FraEgg/commodore-c128dcr-1571-switchless-floppydrive-8x-multi-floppy-speeder/atmega328p/README.md

## ATMega 328P

The Atmel ATMega 328P microcontroller monitors the data bus, controls the ROM banks, and manages the switching of operating modes. The firmware can be programmed using an Arduino board or an AV programmer. I use the XGecu T48 Universal Programmer with an .mpj project file. When programming with the XGecu and the .mpj file, make sure not to program the EEPROM as this can cause an error. This can be disabled in the XGecu menu.
