FraEgg/commodore-c128dcr-1571-switchless-floppydrive-8x-multi-floppy-speeder/images/README.md

# Switchless 8x Multi-Floppy Speeder with 32 KB RAM Expansion for the Commodore C128 DCR and Internal 1571 Floppy Drive (DolphinDOS 3 Compatible)

## Photogallery



### C128D CR 8x Switchless Multi-Speeder and 32KB RAM Expansion PCB (U101)

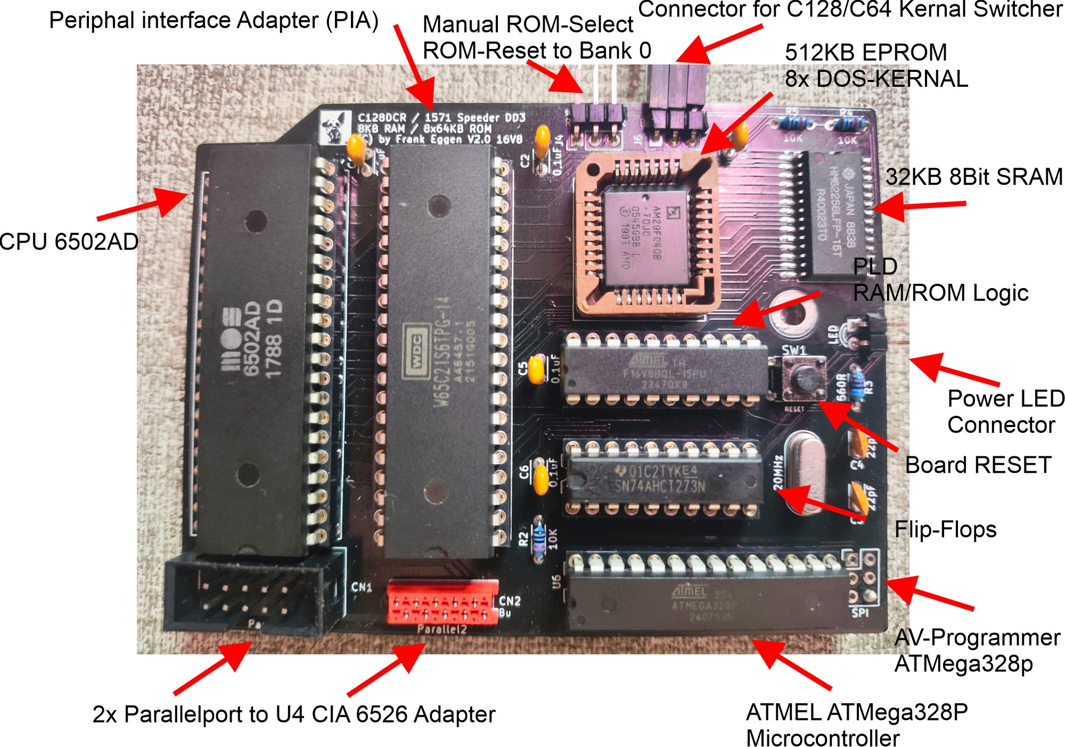
[picture p12: images/V2.0a_Galery2a.jpg]


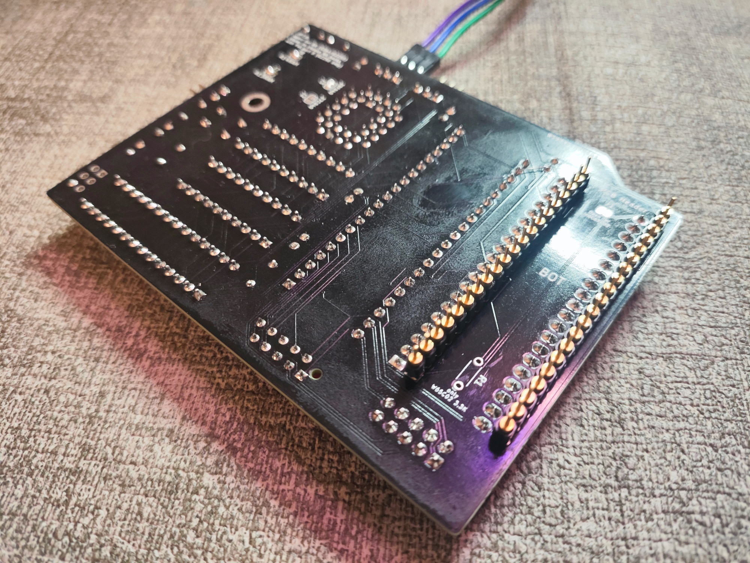
[picture p13: images/V2.0a_Galery3.jpg]


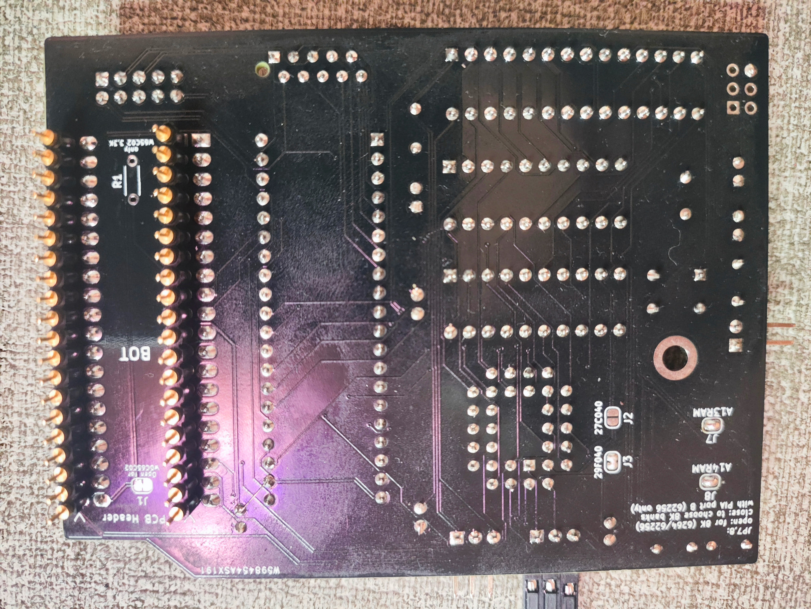
[picture p14: images/V2.0a_Galery4.jpg]


### C128D CR Mainboard Overview



### C128D CR C128/C64 Kernal Switcher (U32)

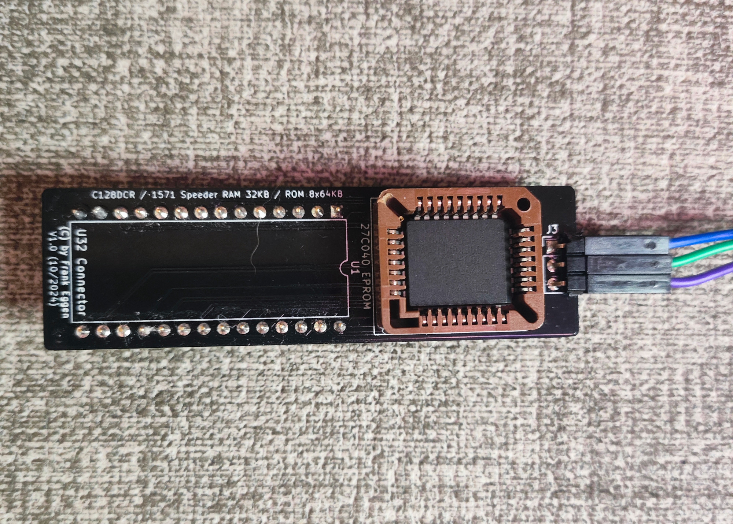
[picture p15: images/V2.0a_Galery5.jpg]


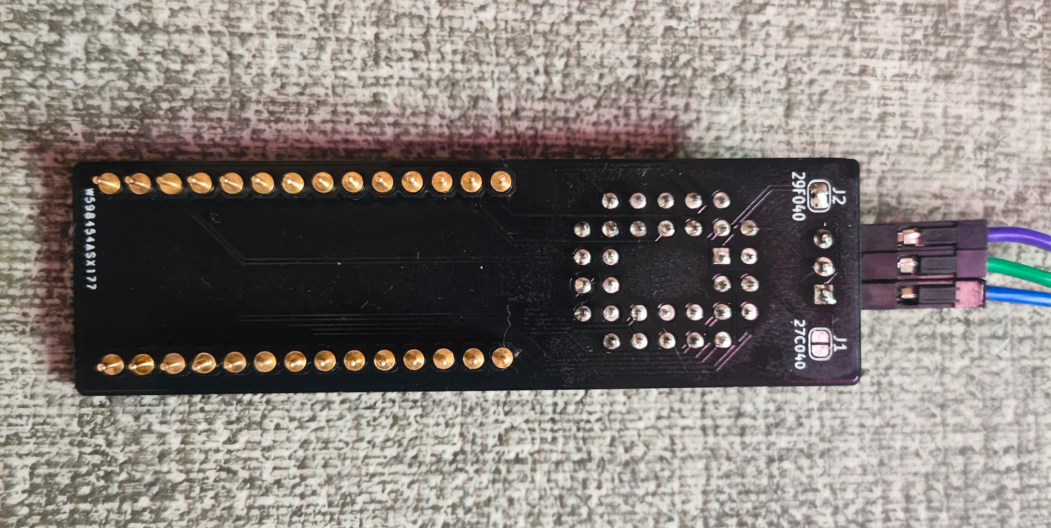
[picture p16: images/V2.0a_Galery6.jpg]


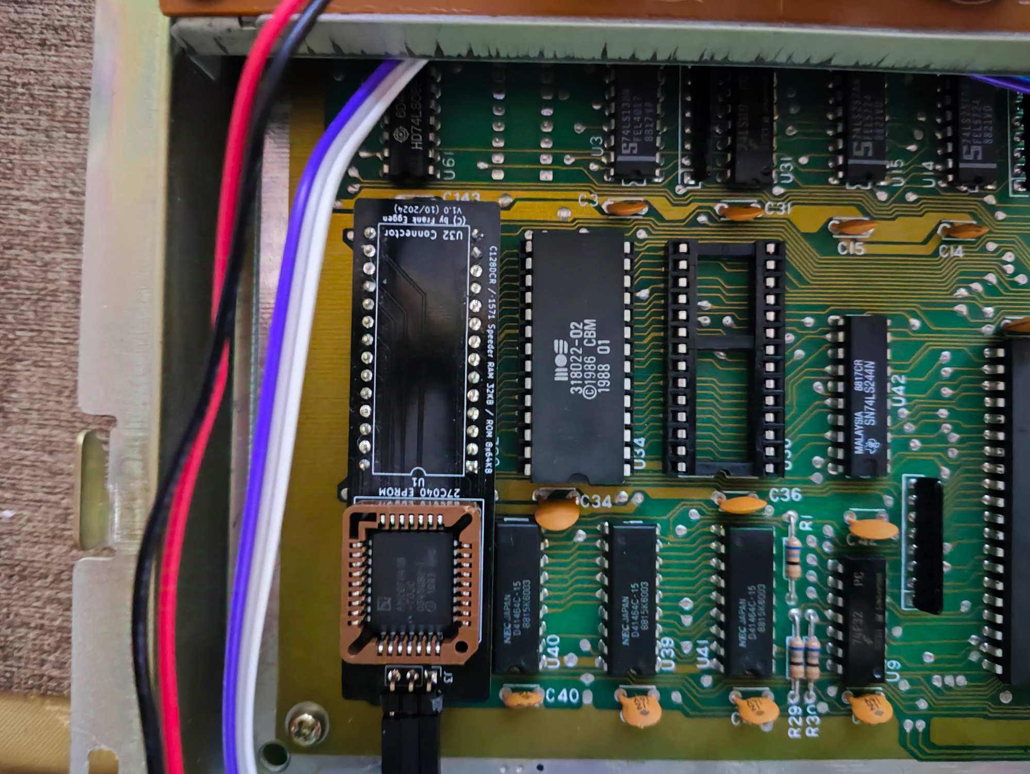
[picture p17: images/V2.0a_Galery11.jpg]


### C128D CR Parallelport-Adapter (U4)

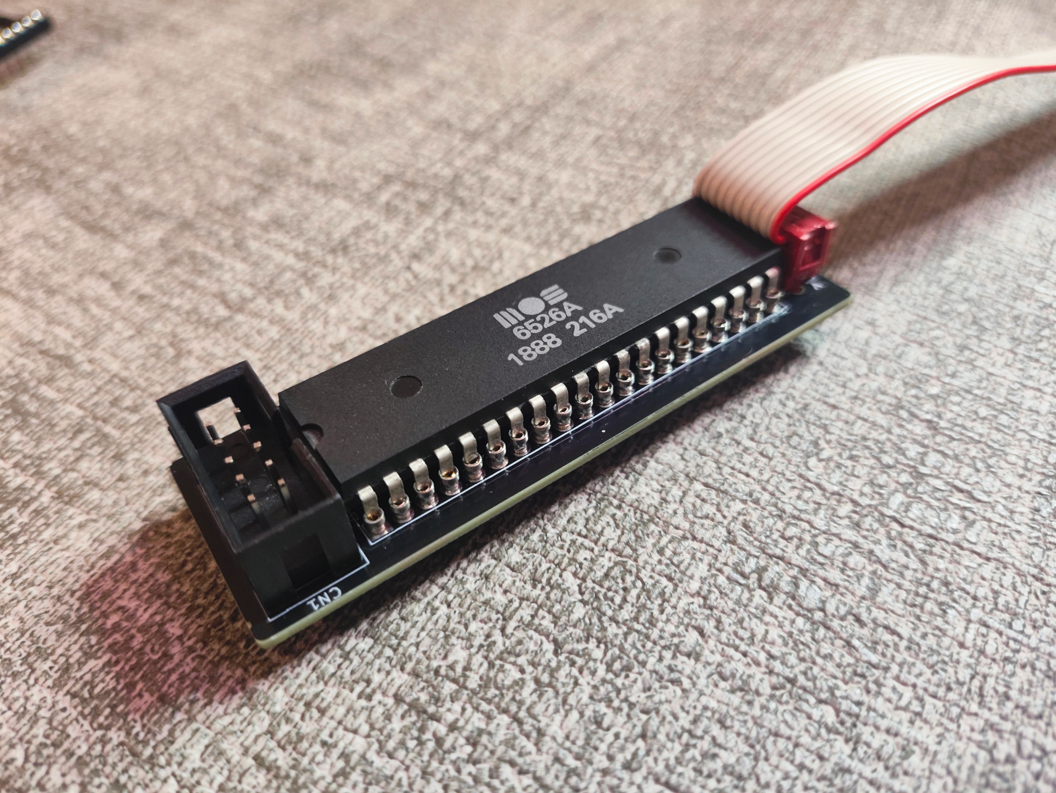
[picture p18: images/V2.0a_Galery7.jpg]


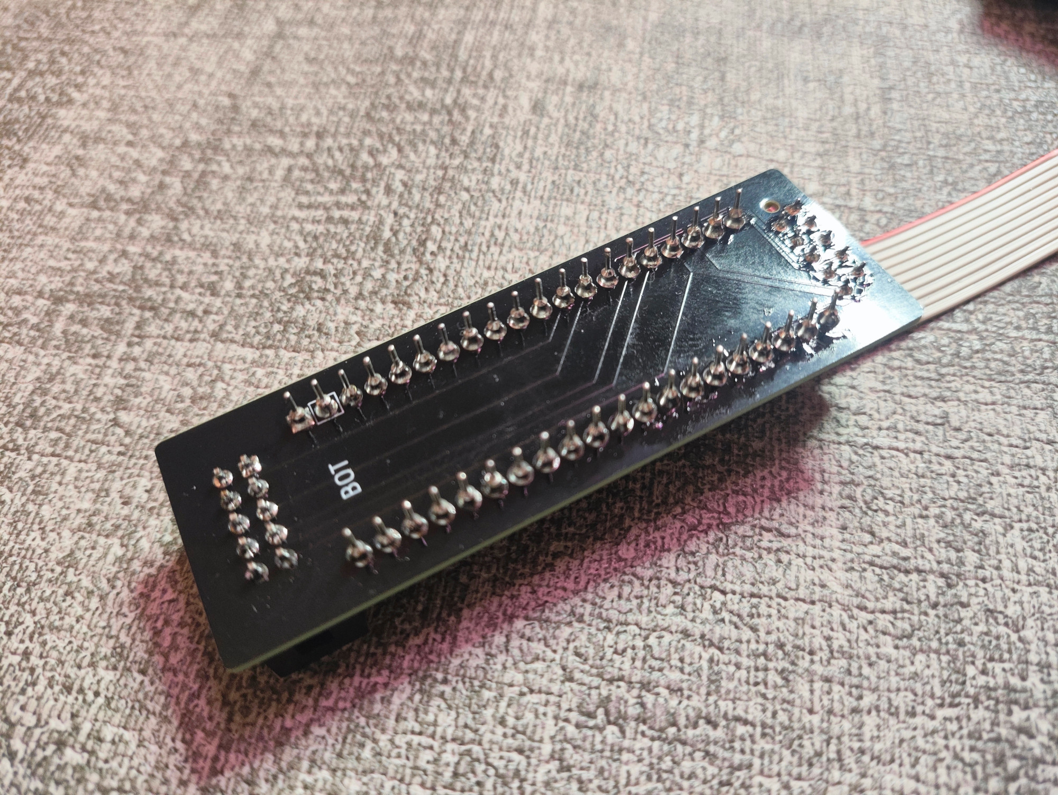
[picture p19: images/V2.0a_Galery8.jpg]


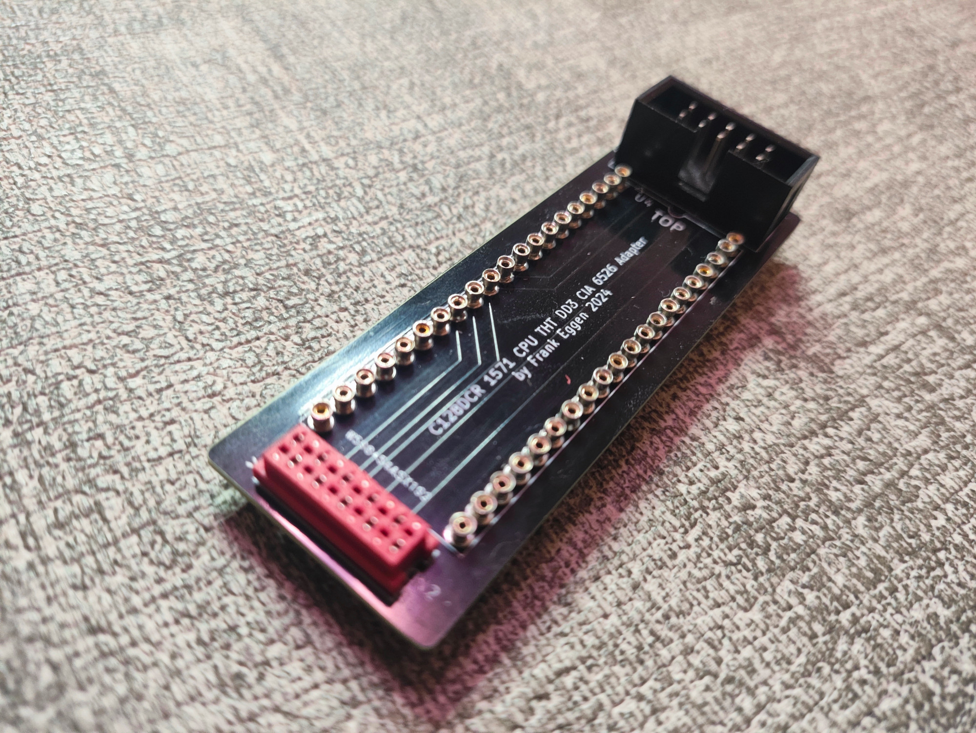
[picture p20: images/V2.0a_Galery9.jpg]


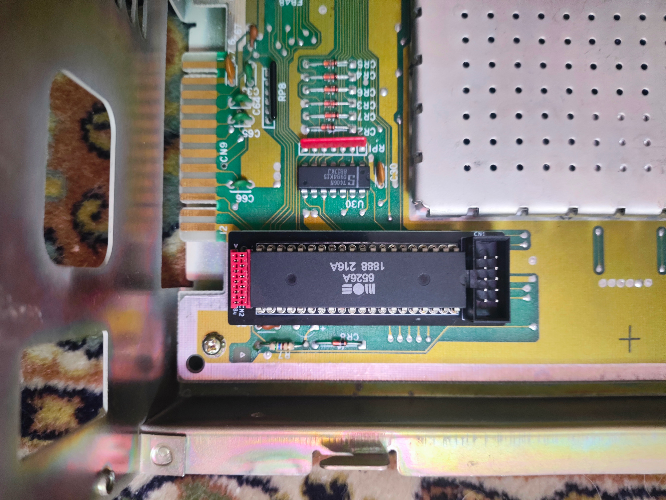
[picture p21: images/V2.0a_Galery10.jpg]


### C128D CR 8x Switchless Multi-Speeder and 32KB RAM Expansion Render PCB

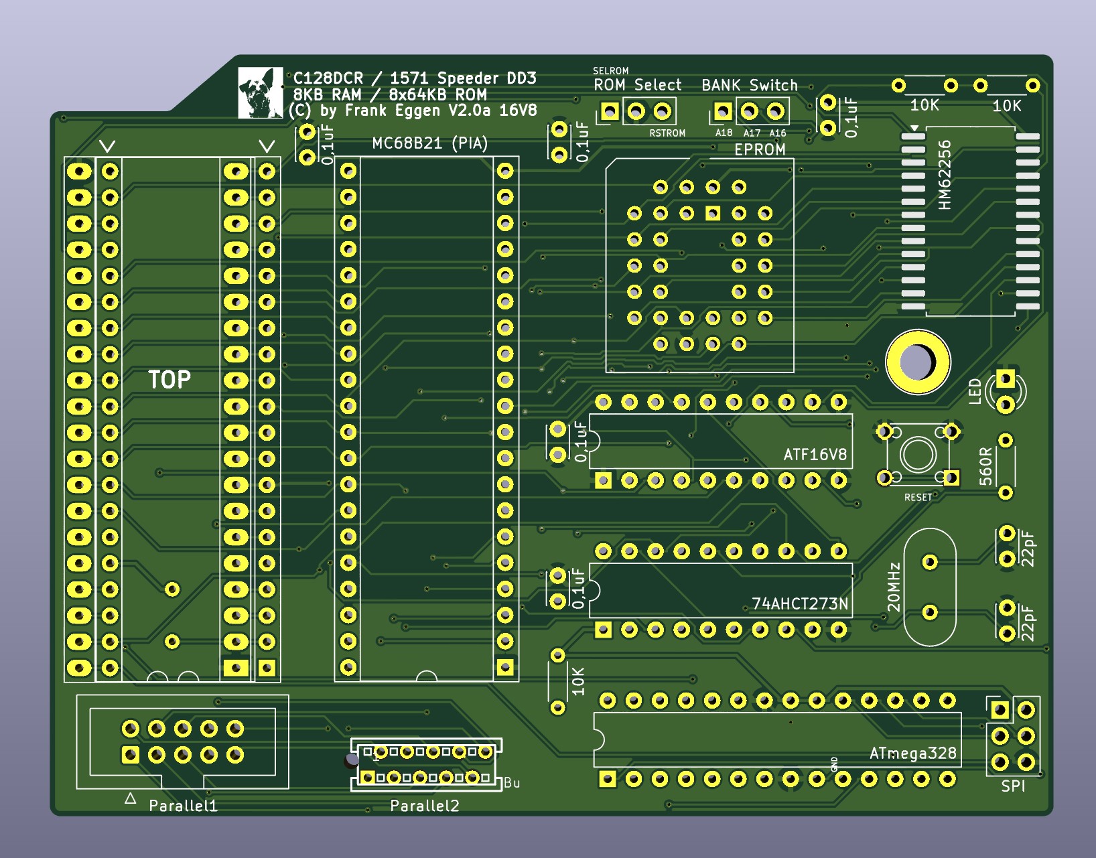
[picture p22: images/V2.0a_Multi-Speeder_PCB_Front_Render.jpg]


### C128D CR Parallelport-Adapter render (U4)

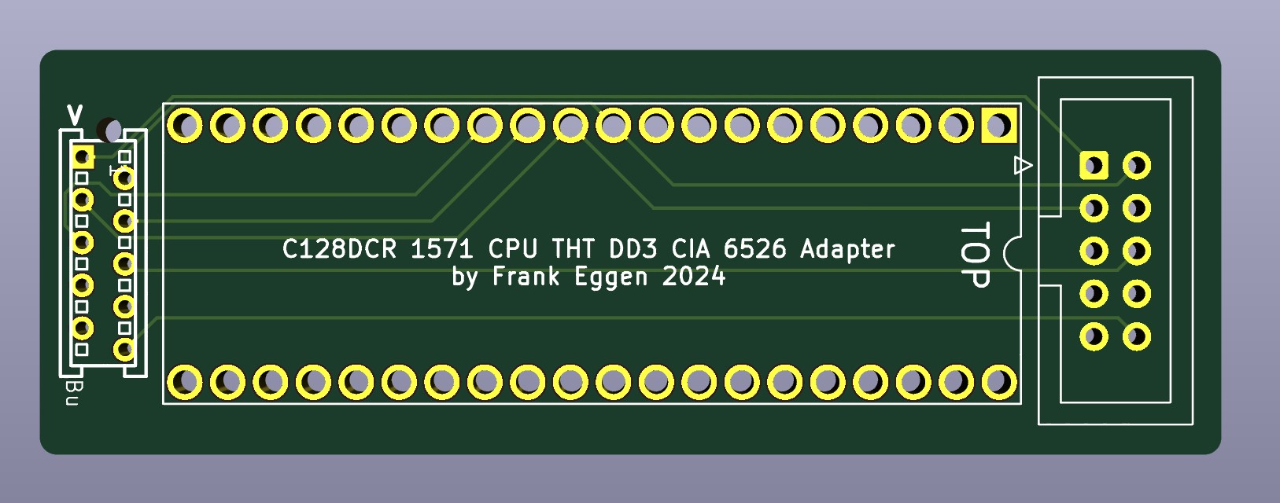
[picture p23: images/V2.0a_Parallelport-Adapter_PCB_Front_Render.jpg]


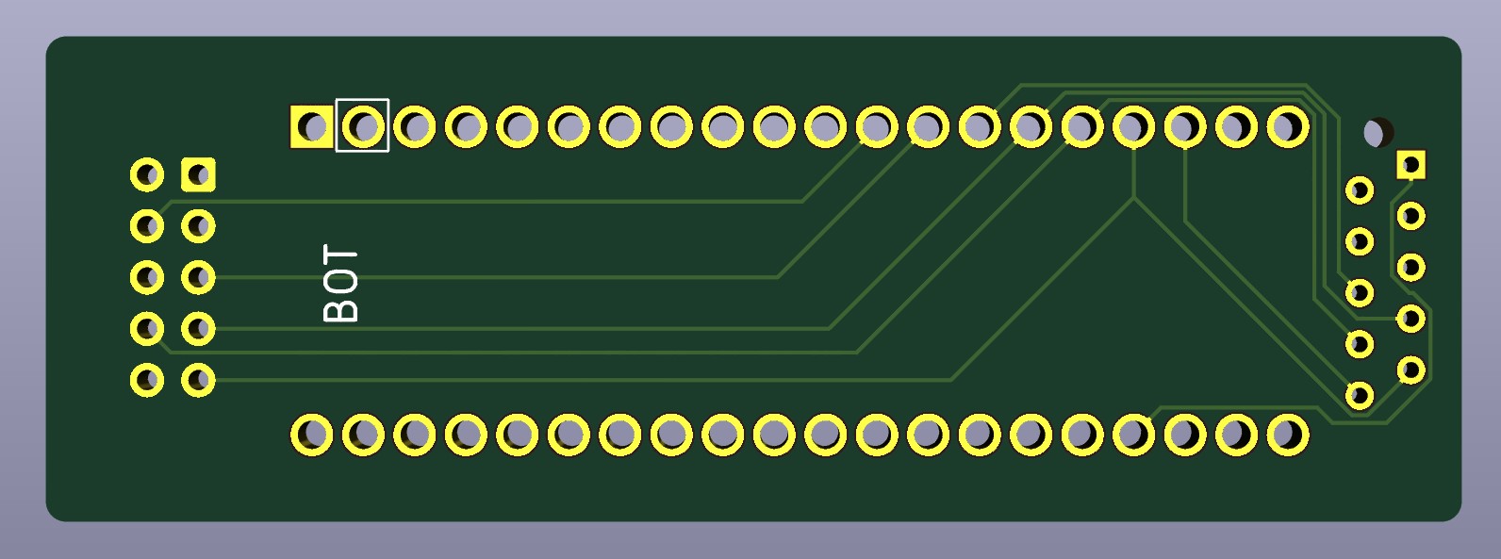
[picture p24: images/V2.0a_Parallelport-Adapter_PCB_Back_Render.jpg]


### C128D CR C128/C64 Kernal Switscher render (U32)

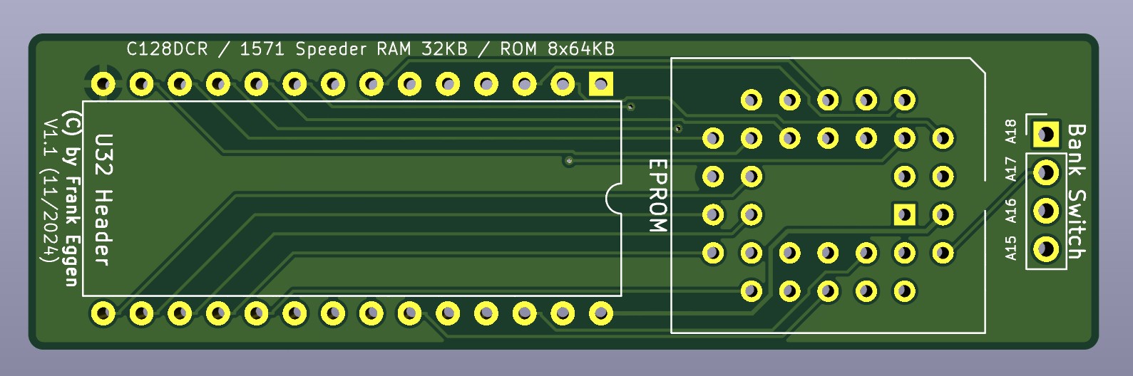
[picture p25: images/V2.0a_U32_Kernal-Switcher-Adapter_PCB_Top_Render.jpg]


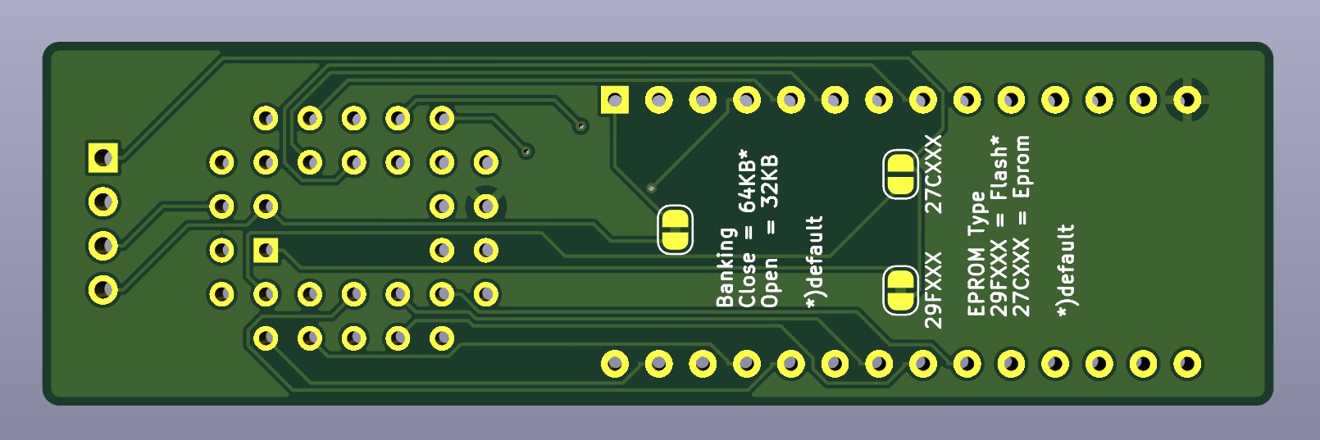
[picture p26: images/V2.0a_U32_Kernal-Switcher-Adapter_PCB_Bot_Render.jpg]


![]()

Best regards,  
Frank Eggen
