FraEgg/commodore-c128dcr-1571-switchless-floppydrive-8x-multi-floppy-speeder/docs/V2.0-8xMulti-Speeder-PCB-Overview.pdf

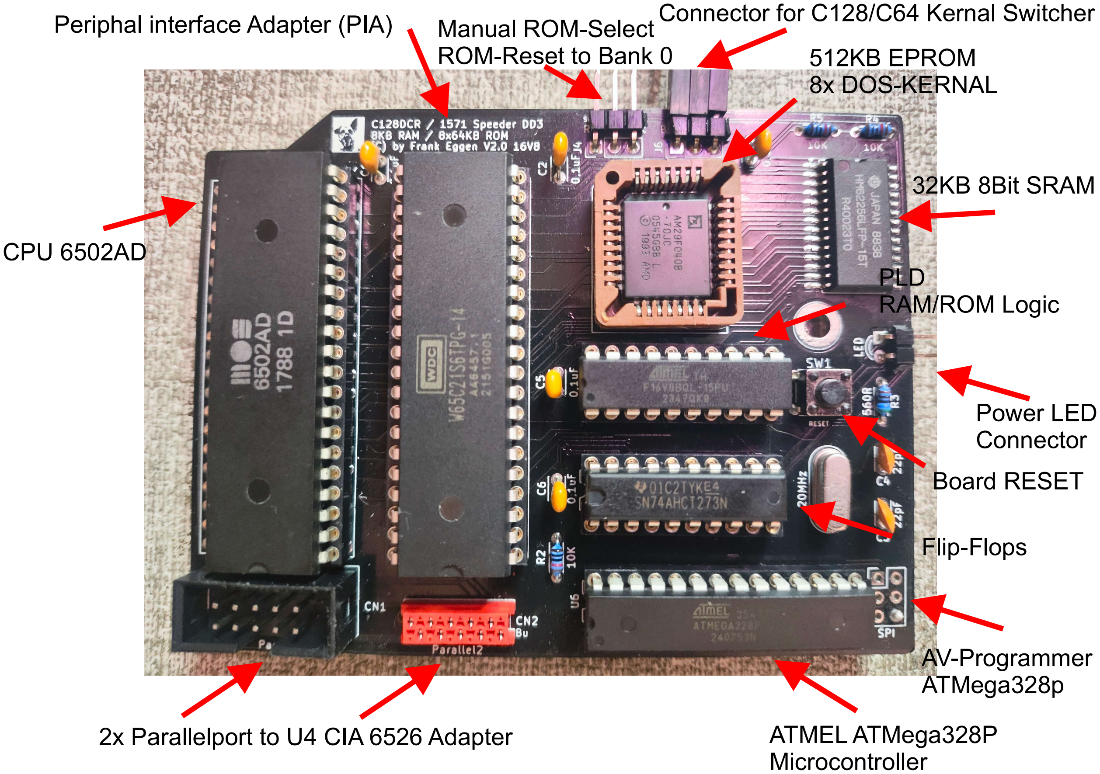
[picture p27: page 1]

Periphal interface Adapter (PIA)

CPU 6502AD

2x Parallelport to U4 CIA 6526 Adapter | ATMEL ATMega328P Microcontroller

Flip-Flops

32KB 8Bit SRAM

PLD
RAM/ROM Logic

Connector for C128/C64 Kernal Switcher

Power LED
Connector

Manual ROM-Select
ROM-Reset to Bank 0 | 512KB EPROM
| 8x DOS-KERNAL

Board RESET

AV-Programmer
ATMega328p
