FraEgg/commodore-c128dcr-1571-switchless-floppydrive-8x-multi-floppy-speeder/images/V2.0_U4_Parallelport-Adapter-Platine.jpg

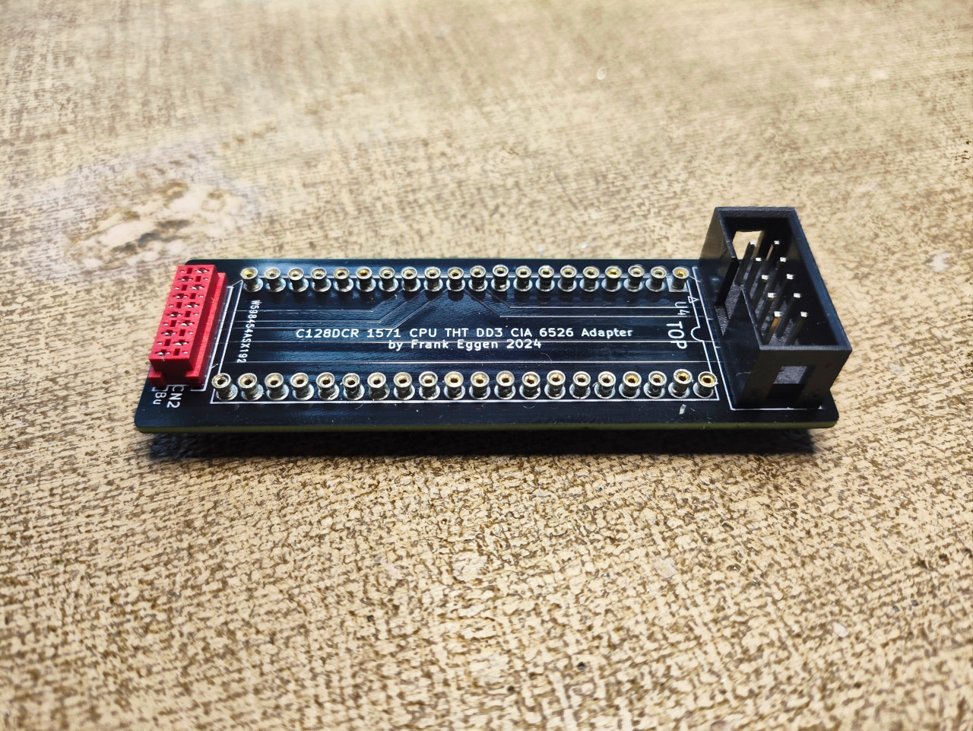
images/V2.0_U4_Parallelport-Adapter-Platine.jpg
