FraEgg/commodore-c128dcr-1571-switchless-floppydrive-8x-multi-floppy-speeder/images/V2.0a_Galery2-rot.jpg

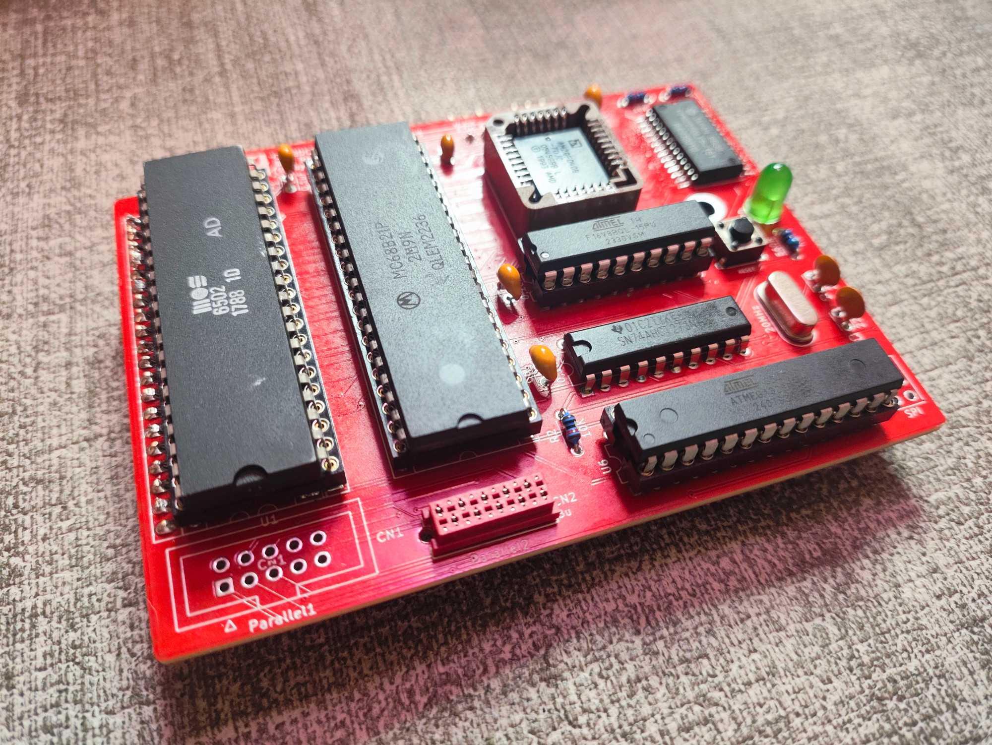
images/V2.0a_Galery2-rot.jpg
