FraEgg/commodore-c128dcr-1571-switchless-floppydrive-8x-multi-floppy-speeder/pld-atf16v8-gal16v8/GAL16V8_PAL_Adressendecoder_V1_1PIA_1571_diagram.png

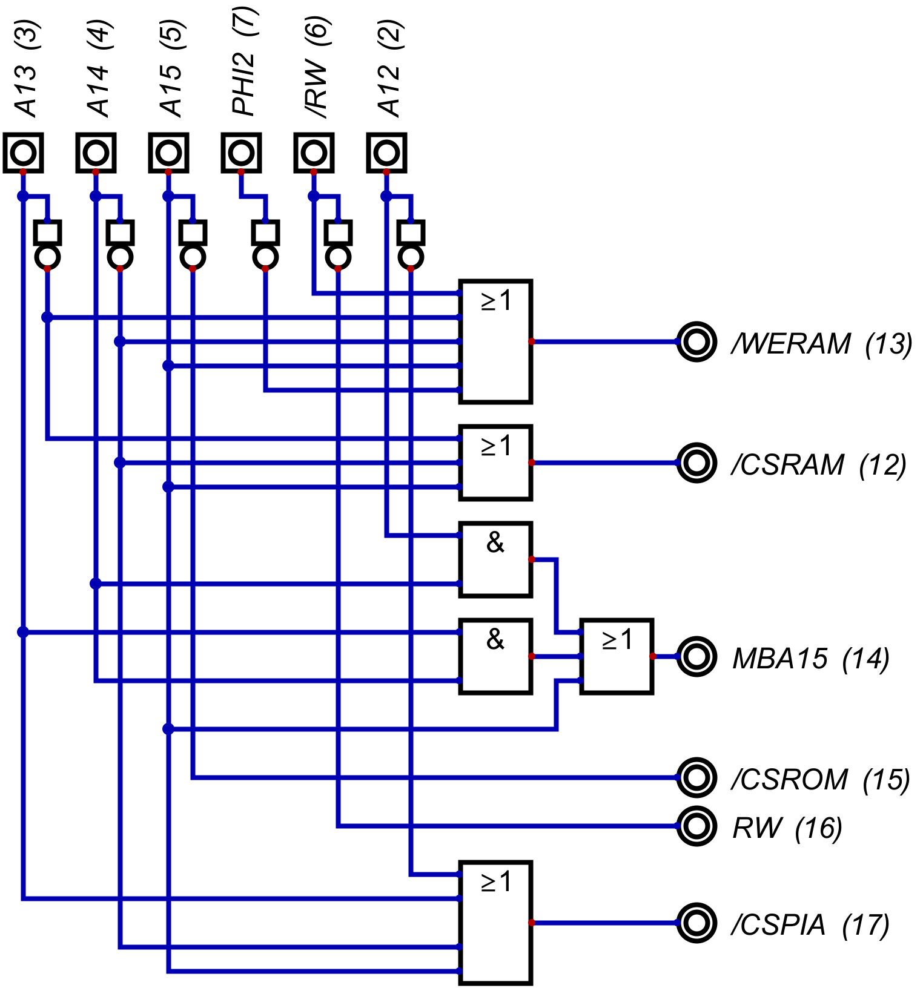
pld-atf16v8-gal16v8/GAL16V8_PAL_Adressendecoder_V1_1PIA_1571_diagram.png
