FraEgg/commodore-c128dcr-1571-switchless-floppydrive-8x-multi-floppy-speeder/benchmark/README.md

# Switchless 8x Multi-Floppy Speeder with 32 KB RAM Expansion for the Commodore C128 DCR and Internal 1571 Floppy Drive (DolphinDOS 3 Compatible)

## Benchmarks

I created these benchmarks with the 64'Speed-Test from Silverdr in C64 mode with the C128DCR and the Multi-Speeder 32KB RAM. 

https://e4aws.silverdr.com/projects/speed_test/

Standard 1571 CBM-DOS (C64 Mode):

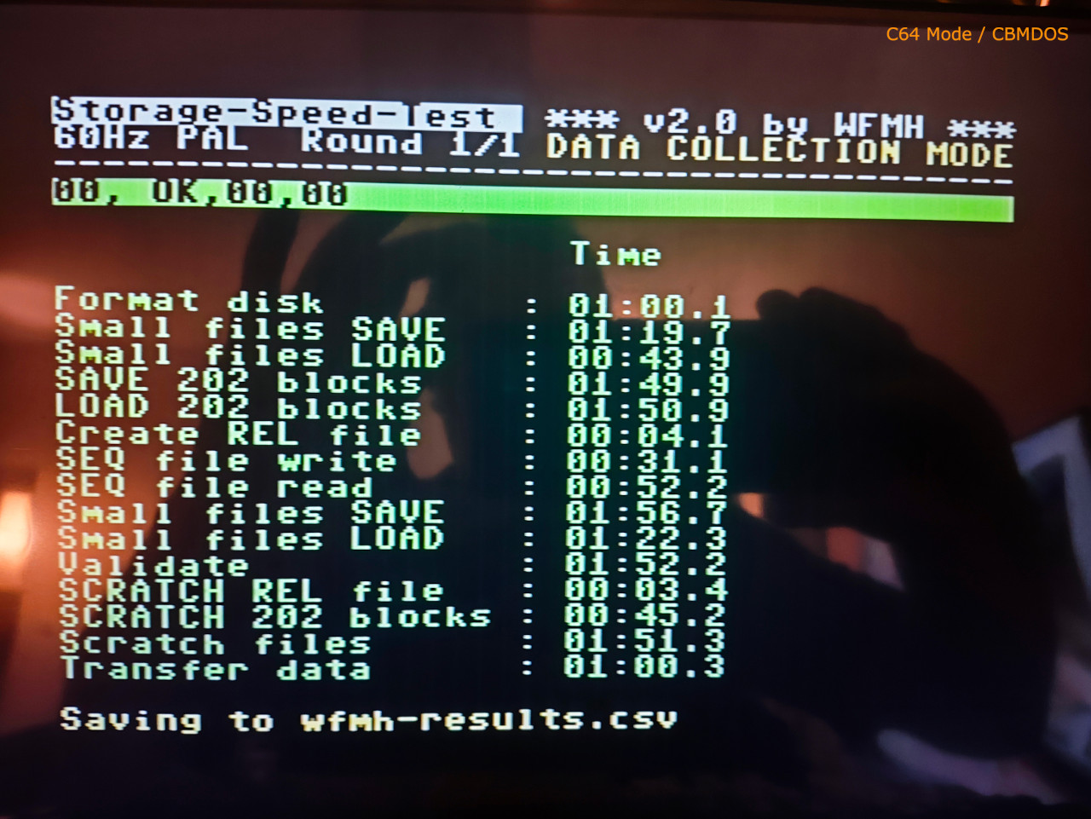
[picture p36: benchmark/IMG_20241204_195851.jpg]


Dolphin Dos 3 1571 (C64 Mode):

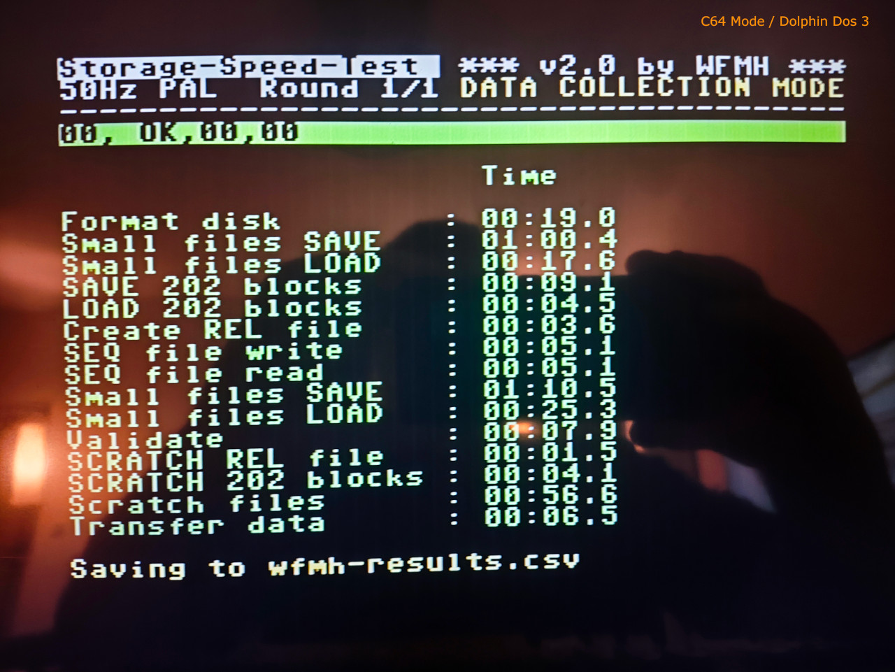
[picture p37: benchmark/IMG_20241204_203727.jpg]


JiffyDOS 1571D(PAL):

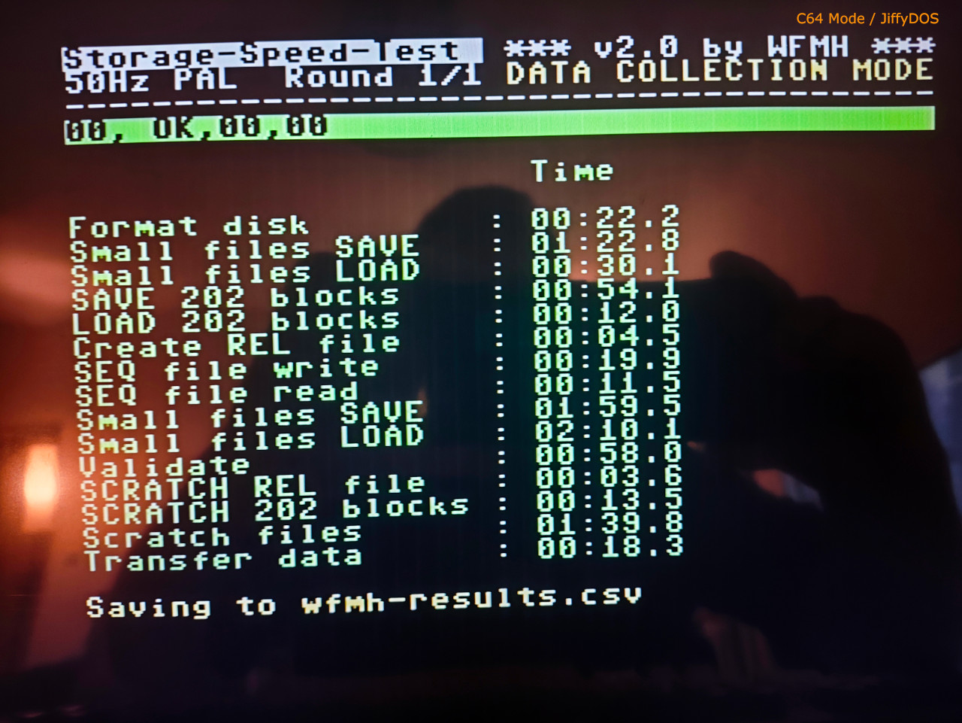
[picture p38: benchmark/IMG_20241204_205006.jpg]


JiffyDOS 128D PAL with RAM-Expansion patch (TrackCache):

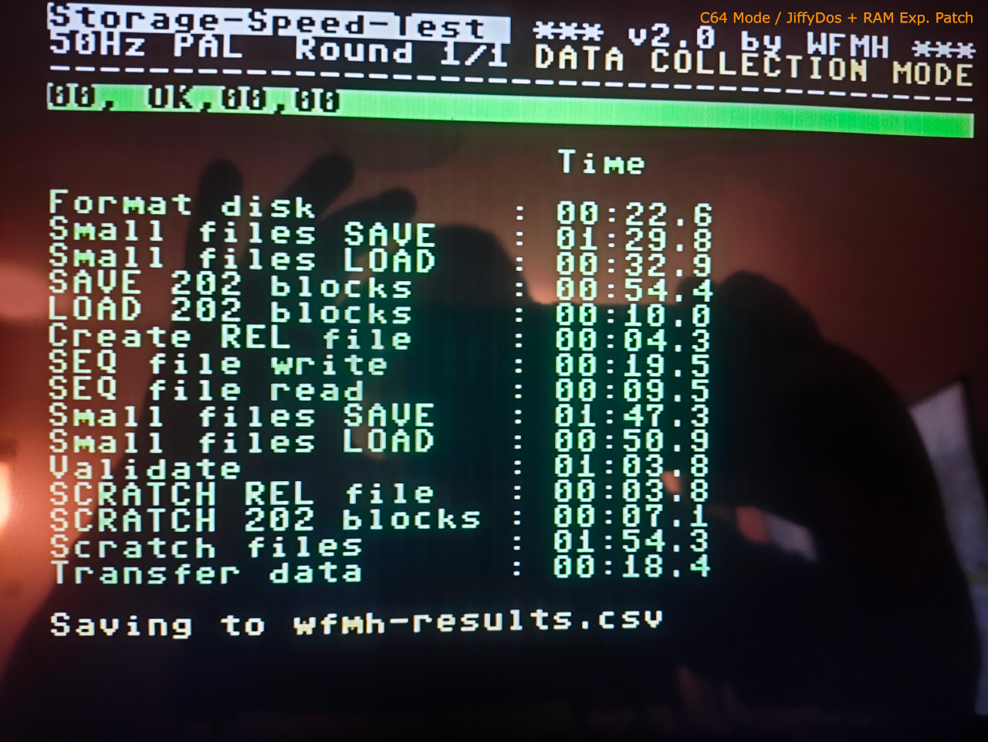
[picture p39: benchmark/IMG_20241204_210317.jpg]


Best regards,  
Frank Eggen
