FraEgg/commodore-c128dcr-1571-switchless-floppydrive-8x-multi-floppy-speeder/schematics/v2.0b_multi-speeder-schematic.pdf

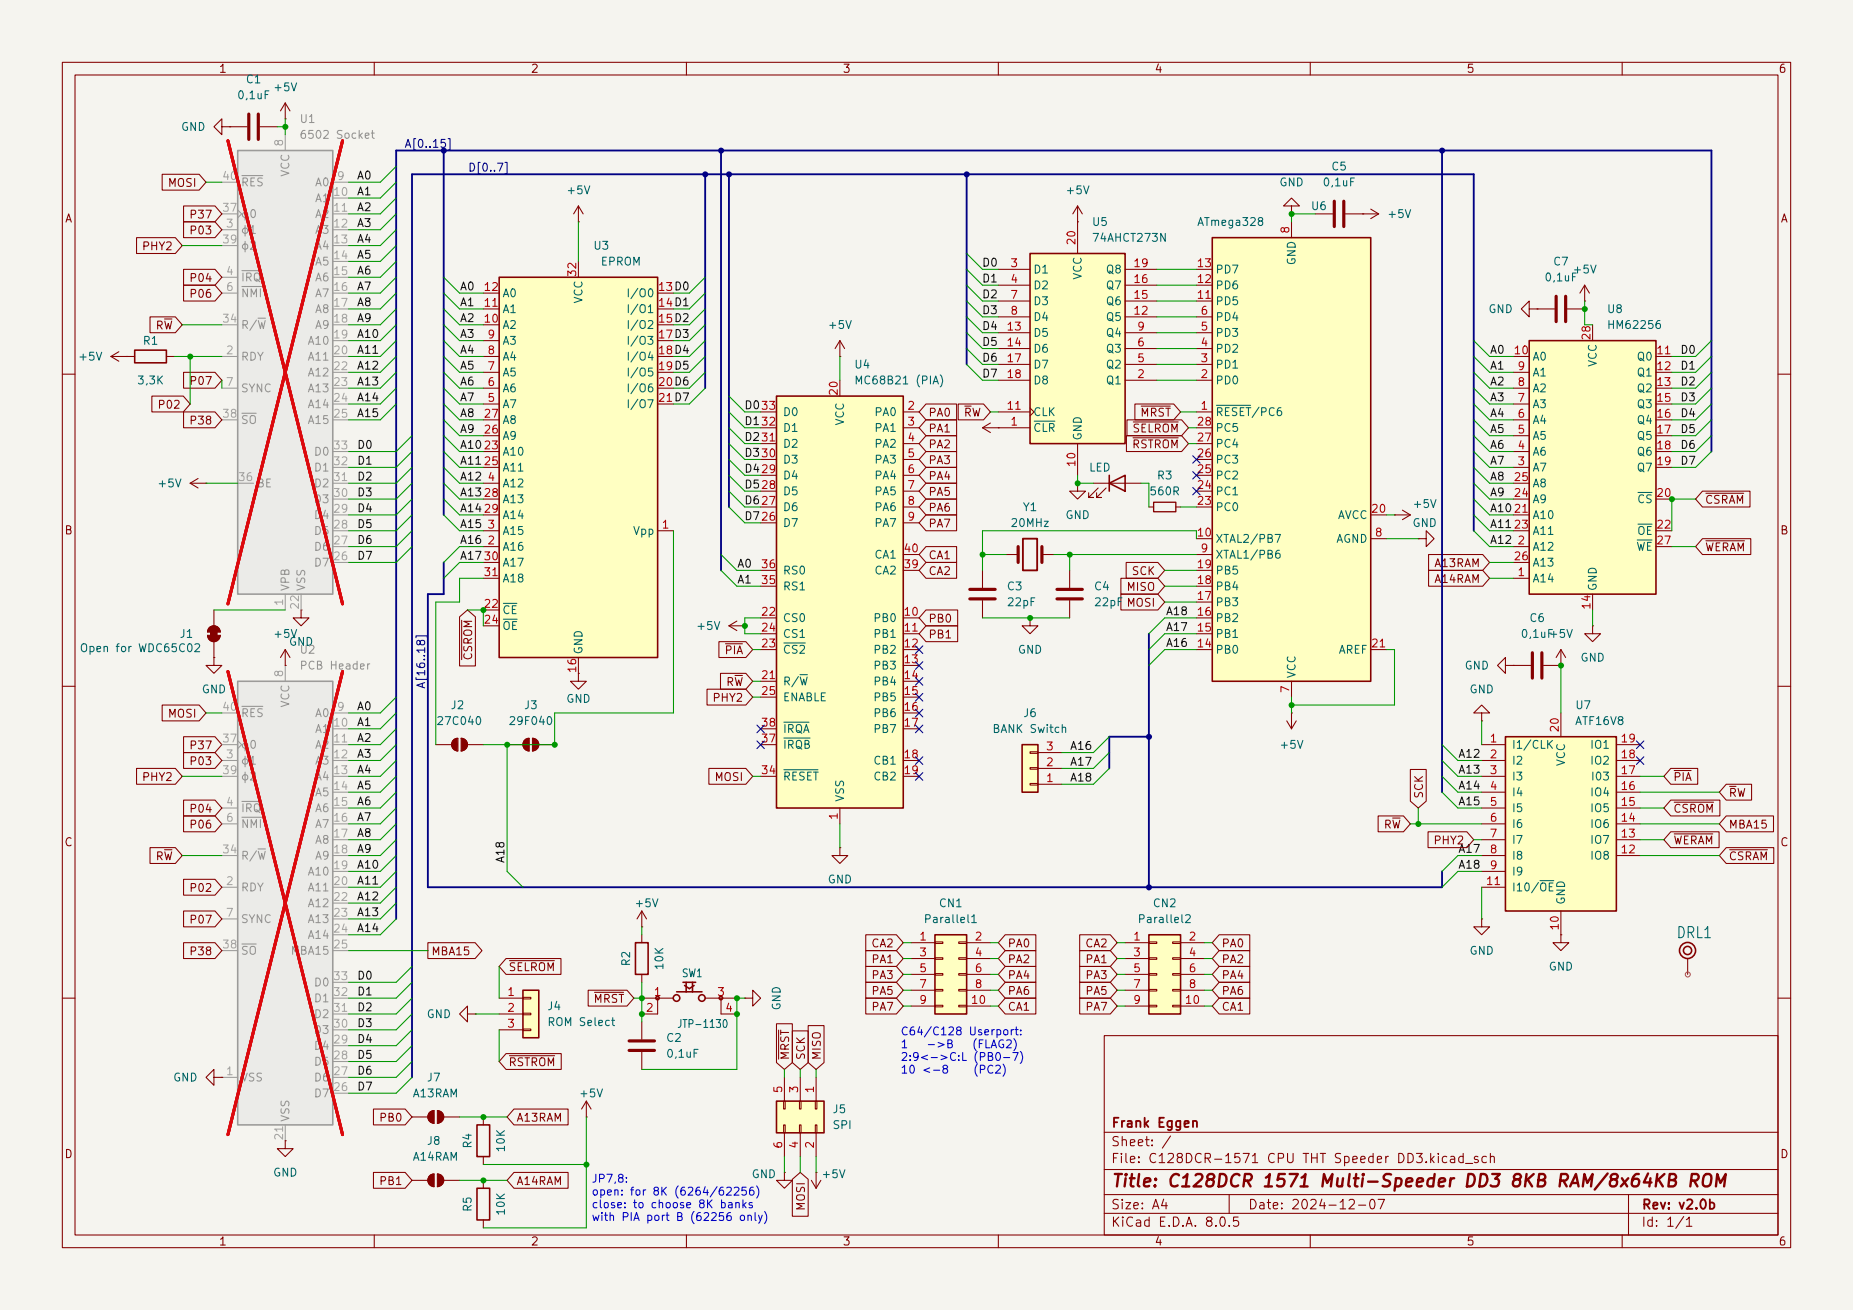
[picture p40: page 1]
