FraEgg/commodore-c128dcr-1571-switchless-floppydrive-8x-multi-floppy-speeder/schematics/v2.0_kernal-switcher-adapter-schematic.pdf

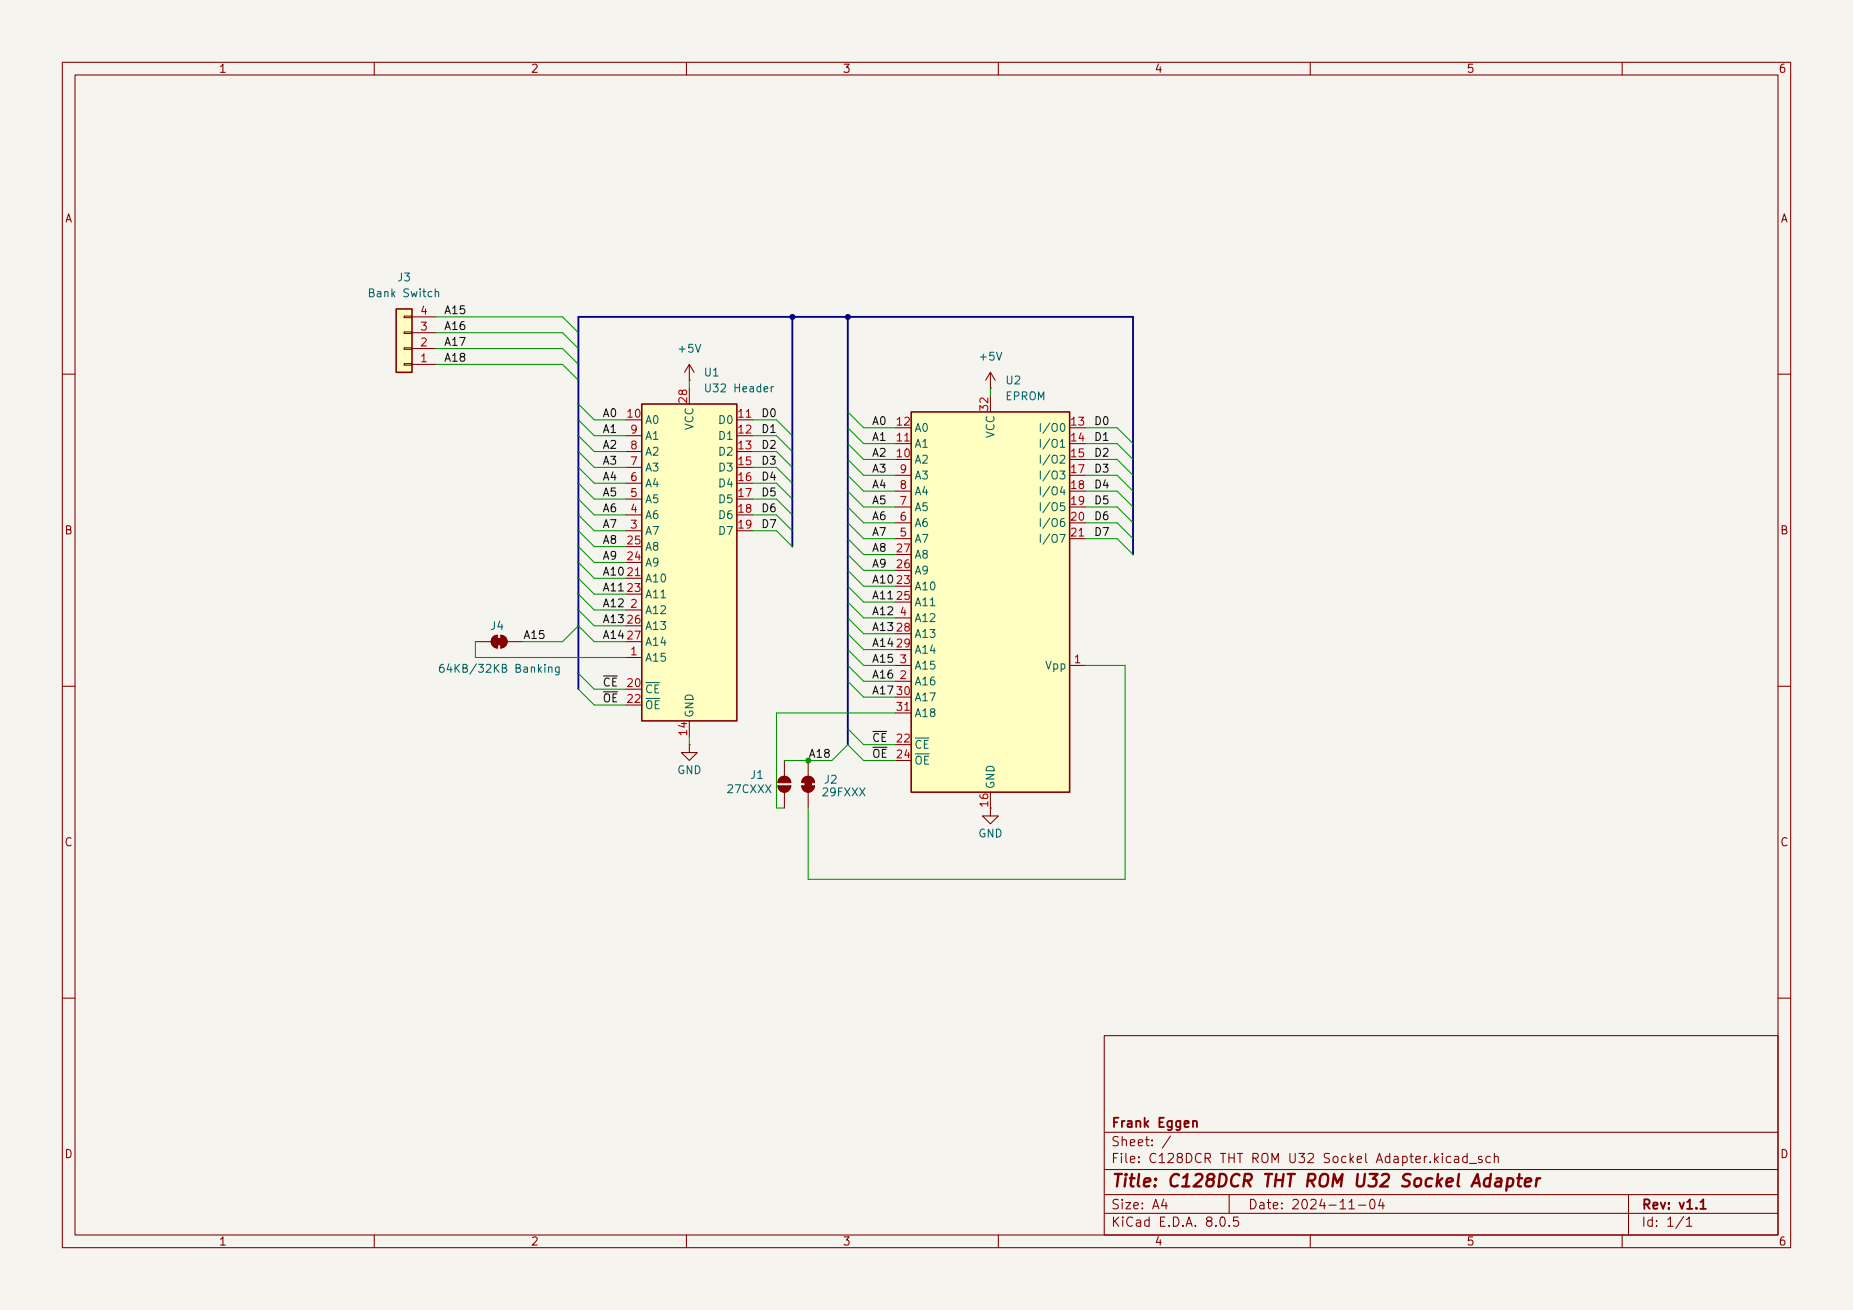
[picture p41: page 1]
