FraEgg/commodore-c128dcr-1571-switchless-floppydrive-8x-multi-floppy-speeder/schematics/v2.0_multi-speeder-schematic.pdf

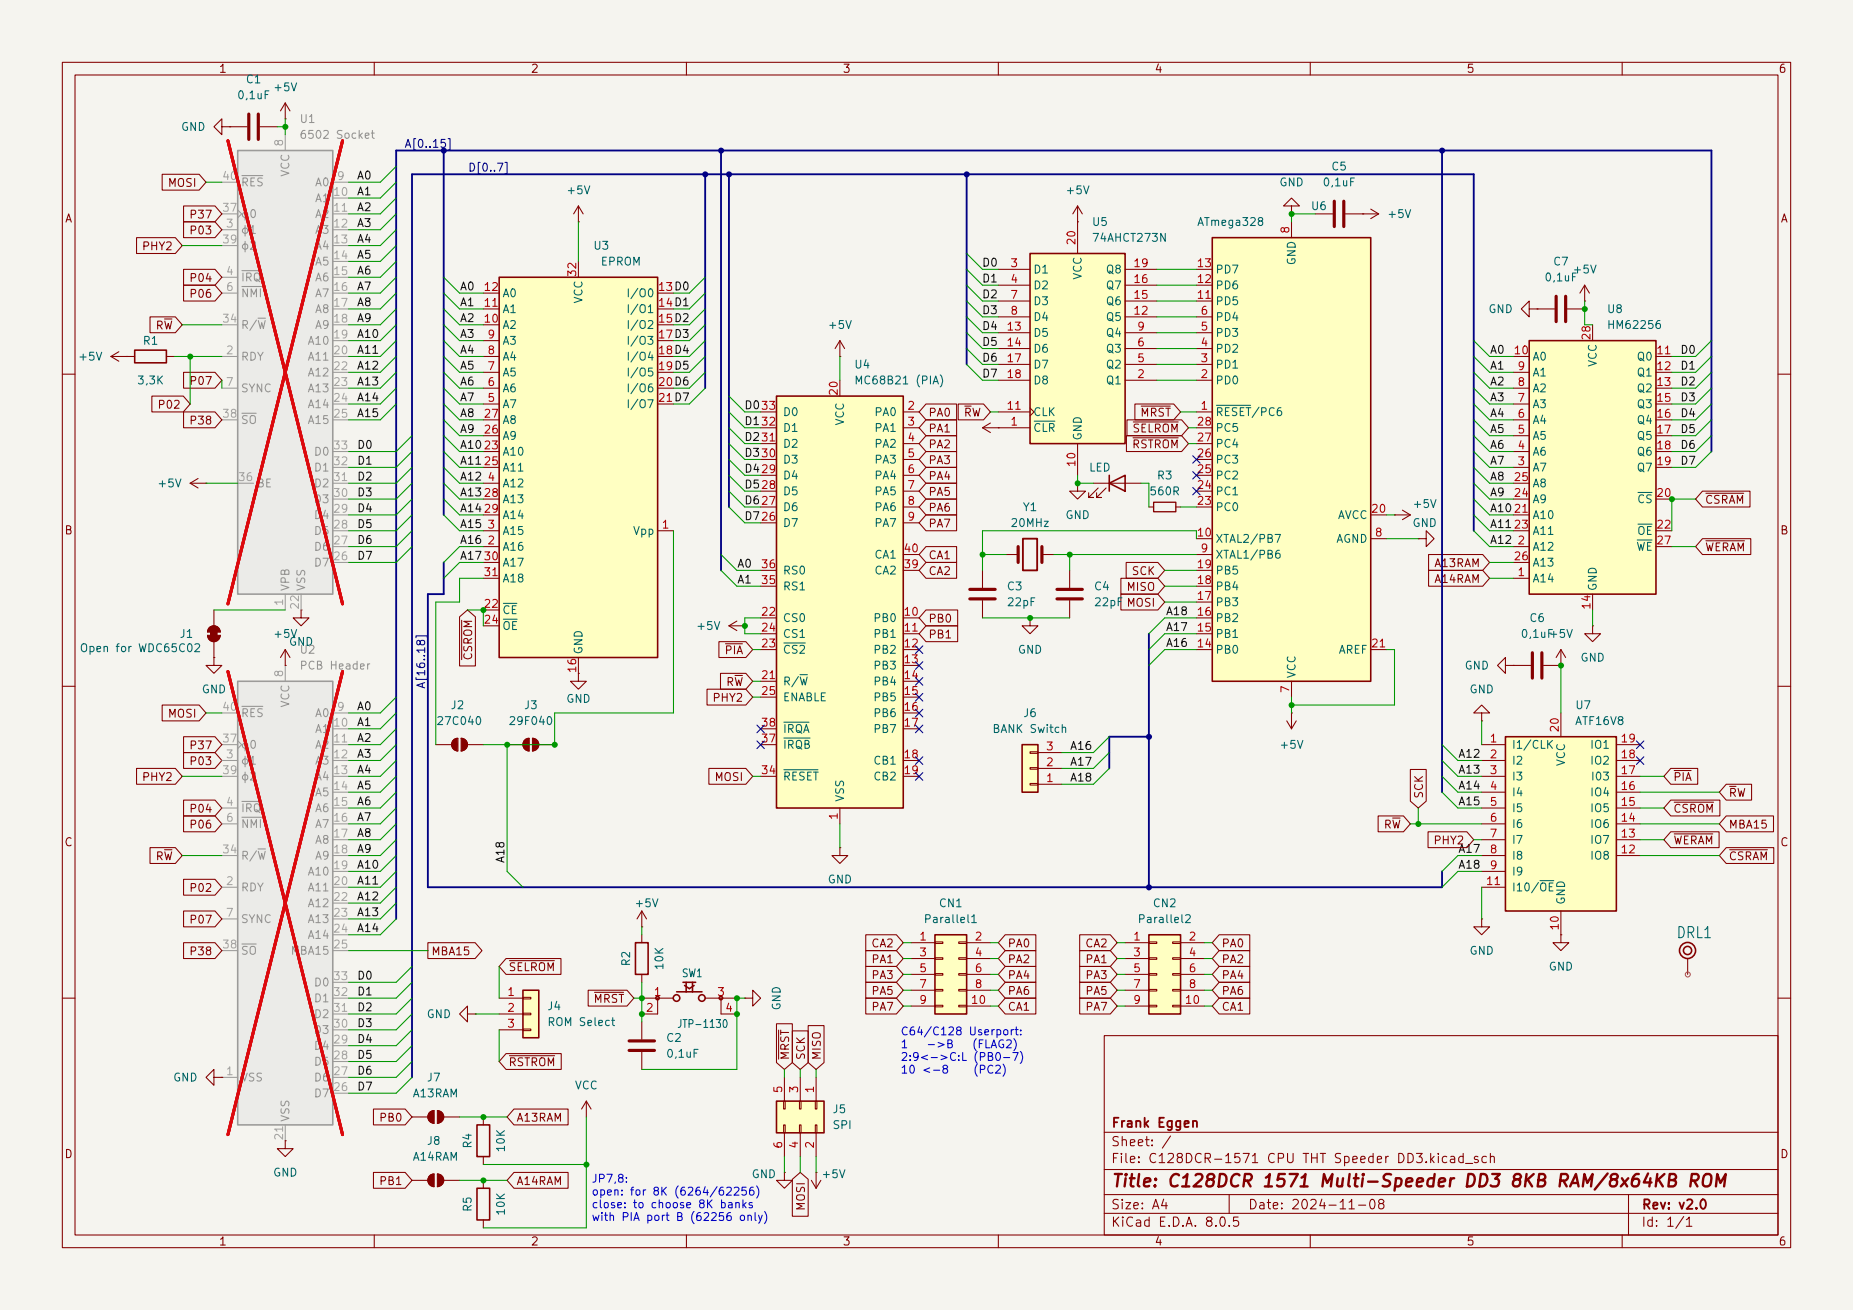
[picture p42: page 1]
