FraEgg/commodore-c128dcr-1571-switchless-floppydrive-8x-multi-floppy-speeder/schematics/v2.0_parallelport-adapter-schematic.pdf

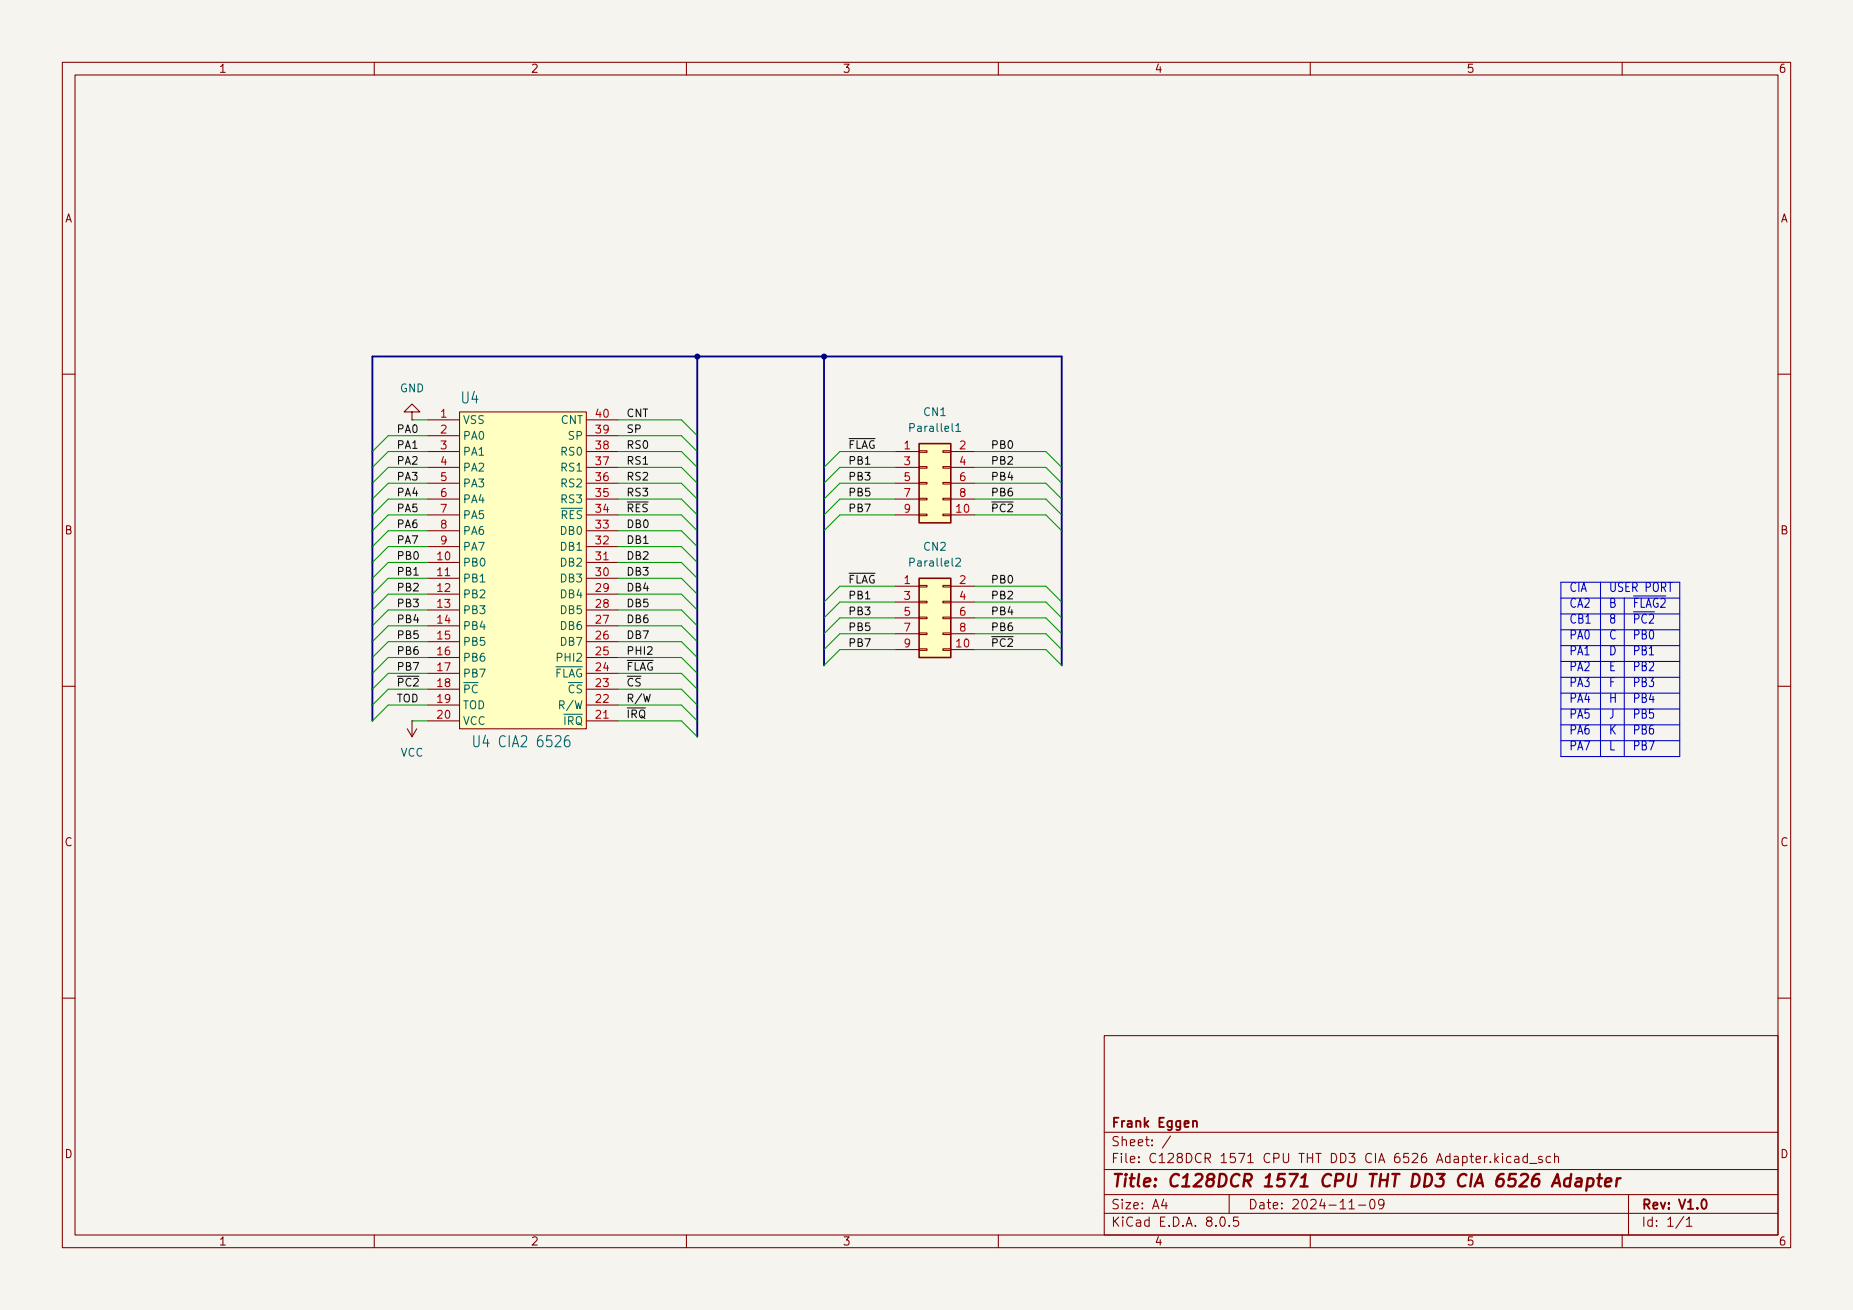
[picture p43: page 1]
