FraEgg/commodore-c128dcr-1571-switchless-floppydrive-8x-multi-floppy-speeder/(commit log)

2024-12-01 Update PCBWay
2024-12-07 Update PCB 2.2b (Resistor R2/R3 fix)
2024-12-14 Add BOM and update Gerber (BOM) and adds
    [v2.0b_BOM_C128DCR-1571_CPU_THT_Speeder_DD3.kicad_pcb.csv, v2.0b_BOM_C128DCR-1571_CPU_THT_Speeder_DD3.kicad_pcb.xls]
2025-01-09 New V2.0b PCB with fixed GND issues
2025-01-12 Update readme / Bank switching for developers
